mSulleza/esp32/hardware/kicad/finished_3d.png

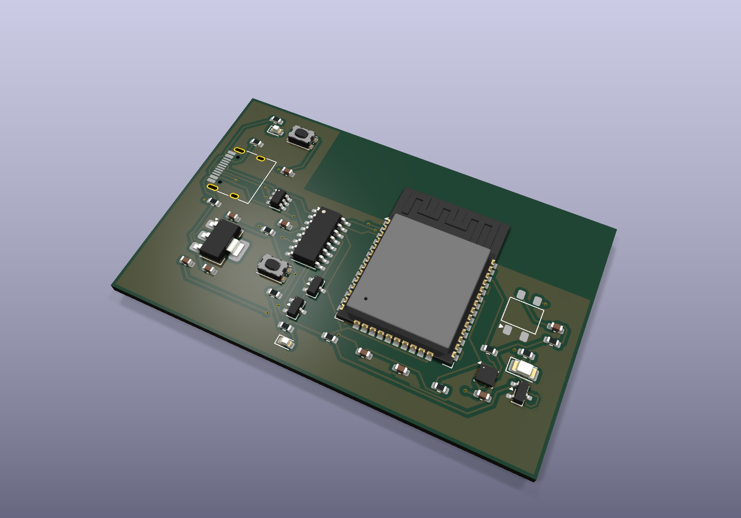
hardware/kicad/finished_3d.png
