mSulleza/esp32/hardware/kicad/placed_top.png

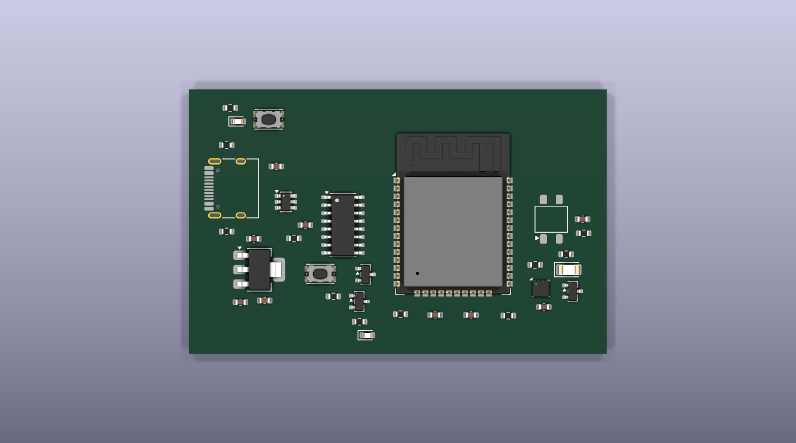
hardware/kicad/placed_top.png
