mSulleza/esp32/hardware/enclosure/enclosure_3d.png

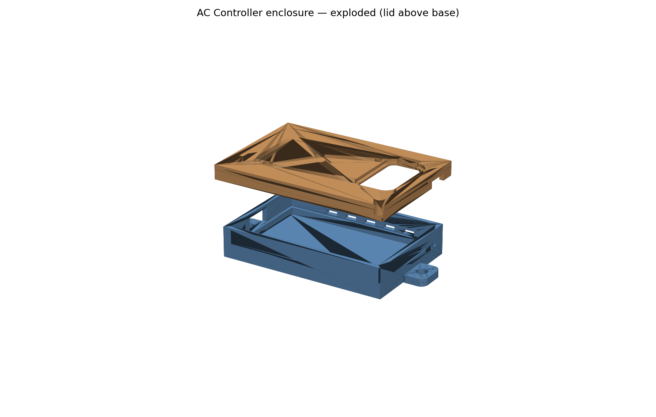
hardware/enclosure/enclosure_3d.png
