mSulleza/esp32/hardware/enclosure/enclosure_plan.png

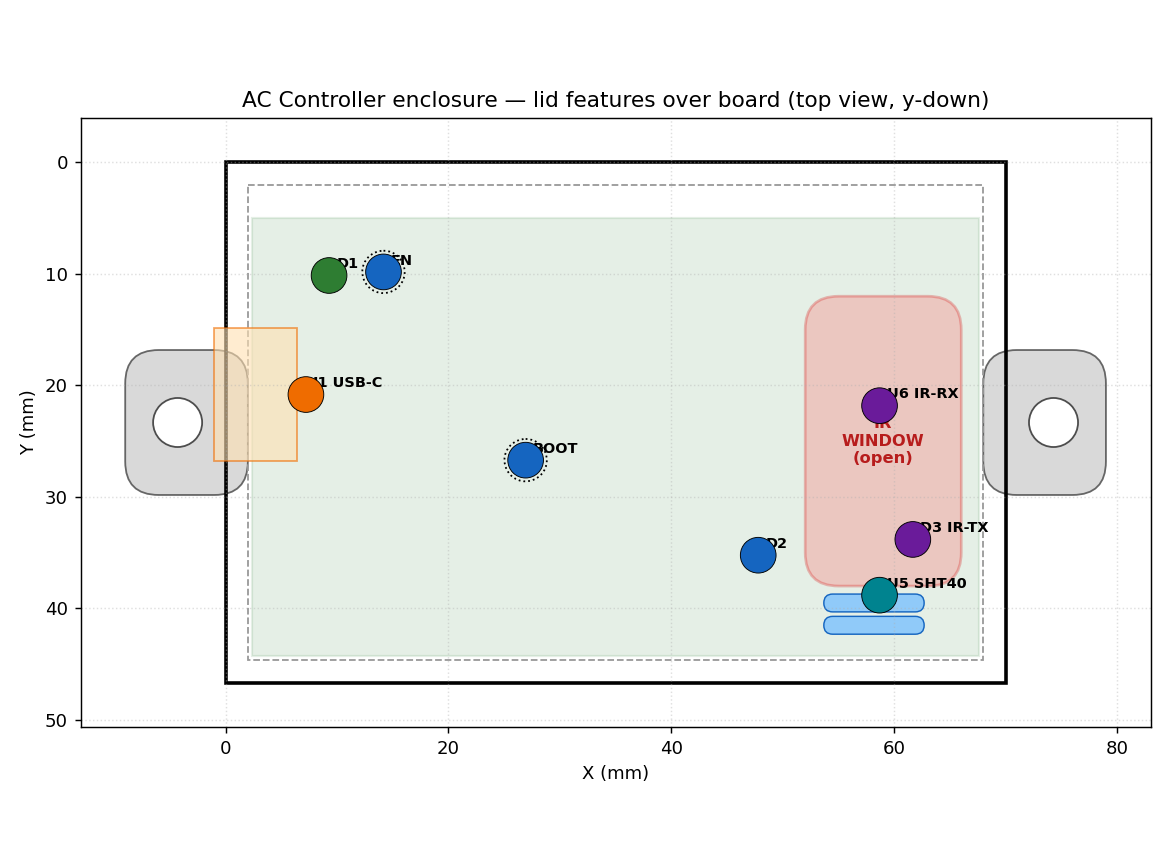
hardware/enclosure/enclosure_plan.png
