mSulleza/esp32/hardware/fab-sht40/ac_controller_top.png

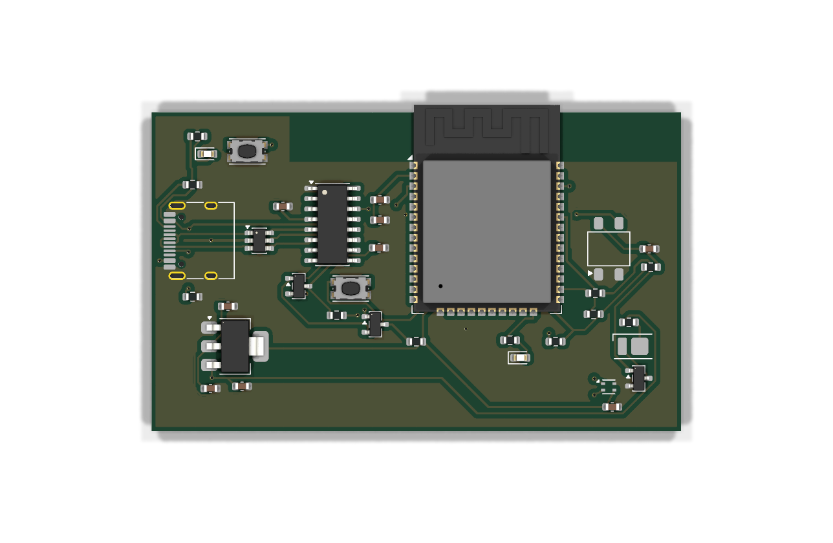
hardware/fab-sht40/ac_controller_top.png
