mSulleza/esp32/hardware/kicad/board3d.png

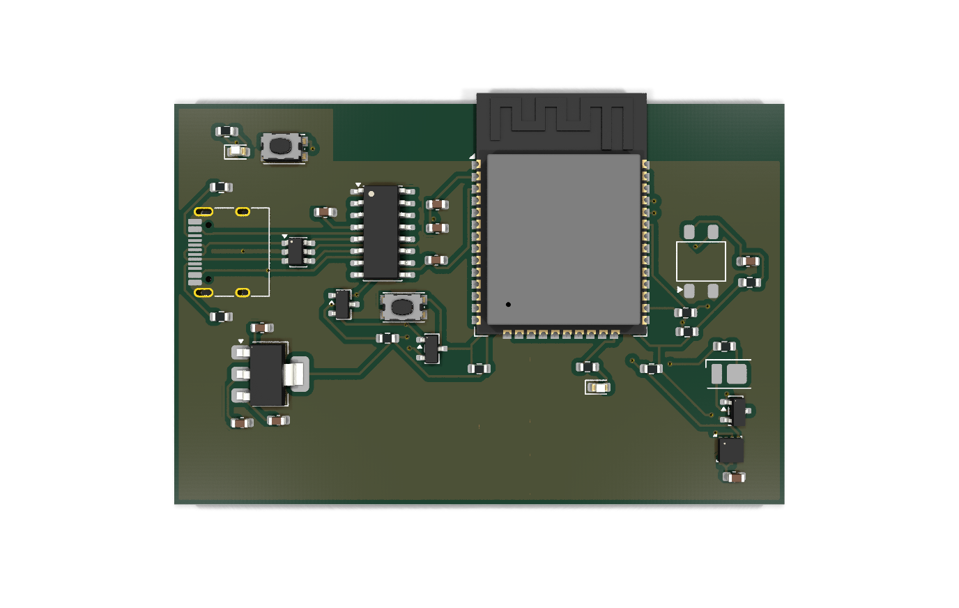
hardware/kicad/board3d.png
