mSulleza/esp32/hardware/enclosure/lid.stl

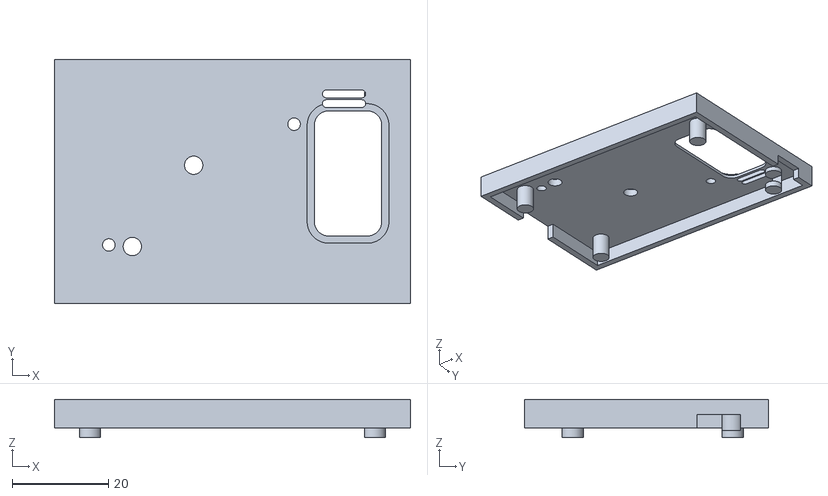
[picture p7: CAD file, 2026-07-01]
hardware/enclosure/lid.stl
74.0 x 50.7 x 8.00
