mSulleza/esp32/hardware/enclosure/ac_controller_enclosure.3mf

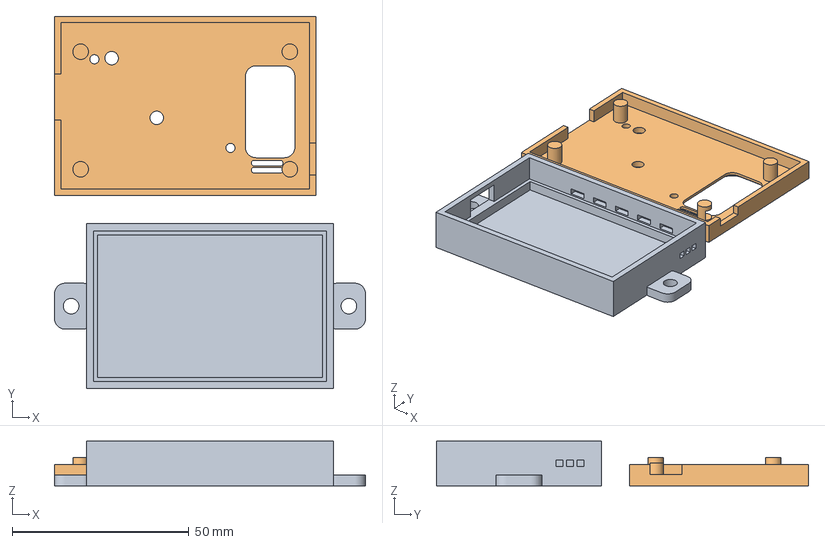
[picture p8: CAD file, 2026-07-01]
hardware/enclosure/ac_controller_enclosure.3mf
88.0 x 105.3 x 12.6 mm
base
lid_print_top_down
