mSulleza/esp32/hardware/enclosure/base.stl

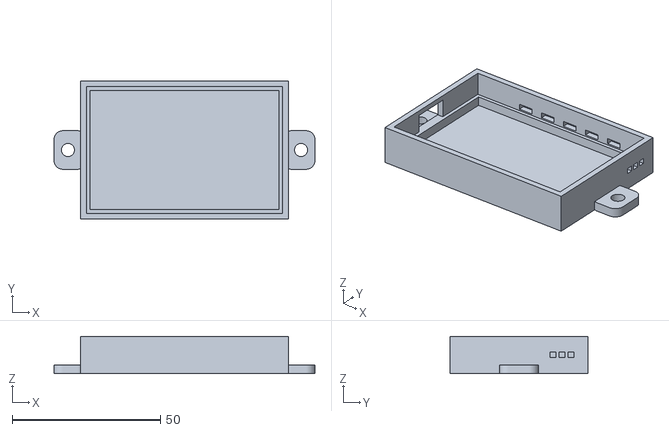
[picture p9: CAD file, 2026-07-01]
hardware/enclosure/base.stl
88.0 x 46.7 x 12.6
