mSulleza/esp32/hardware/kicad/ac_controller.pdf

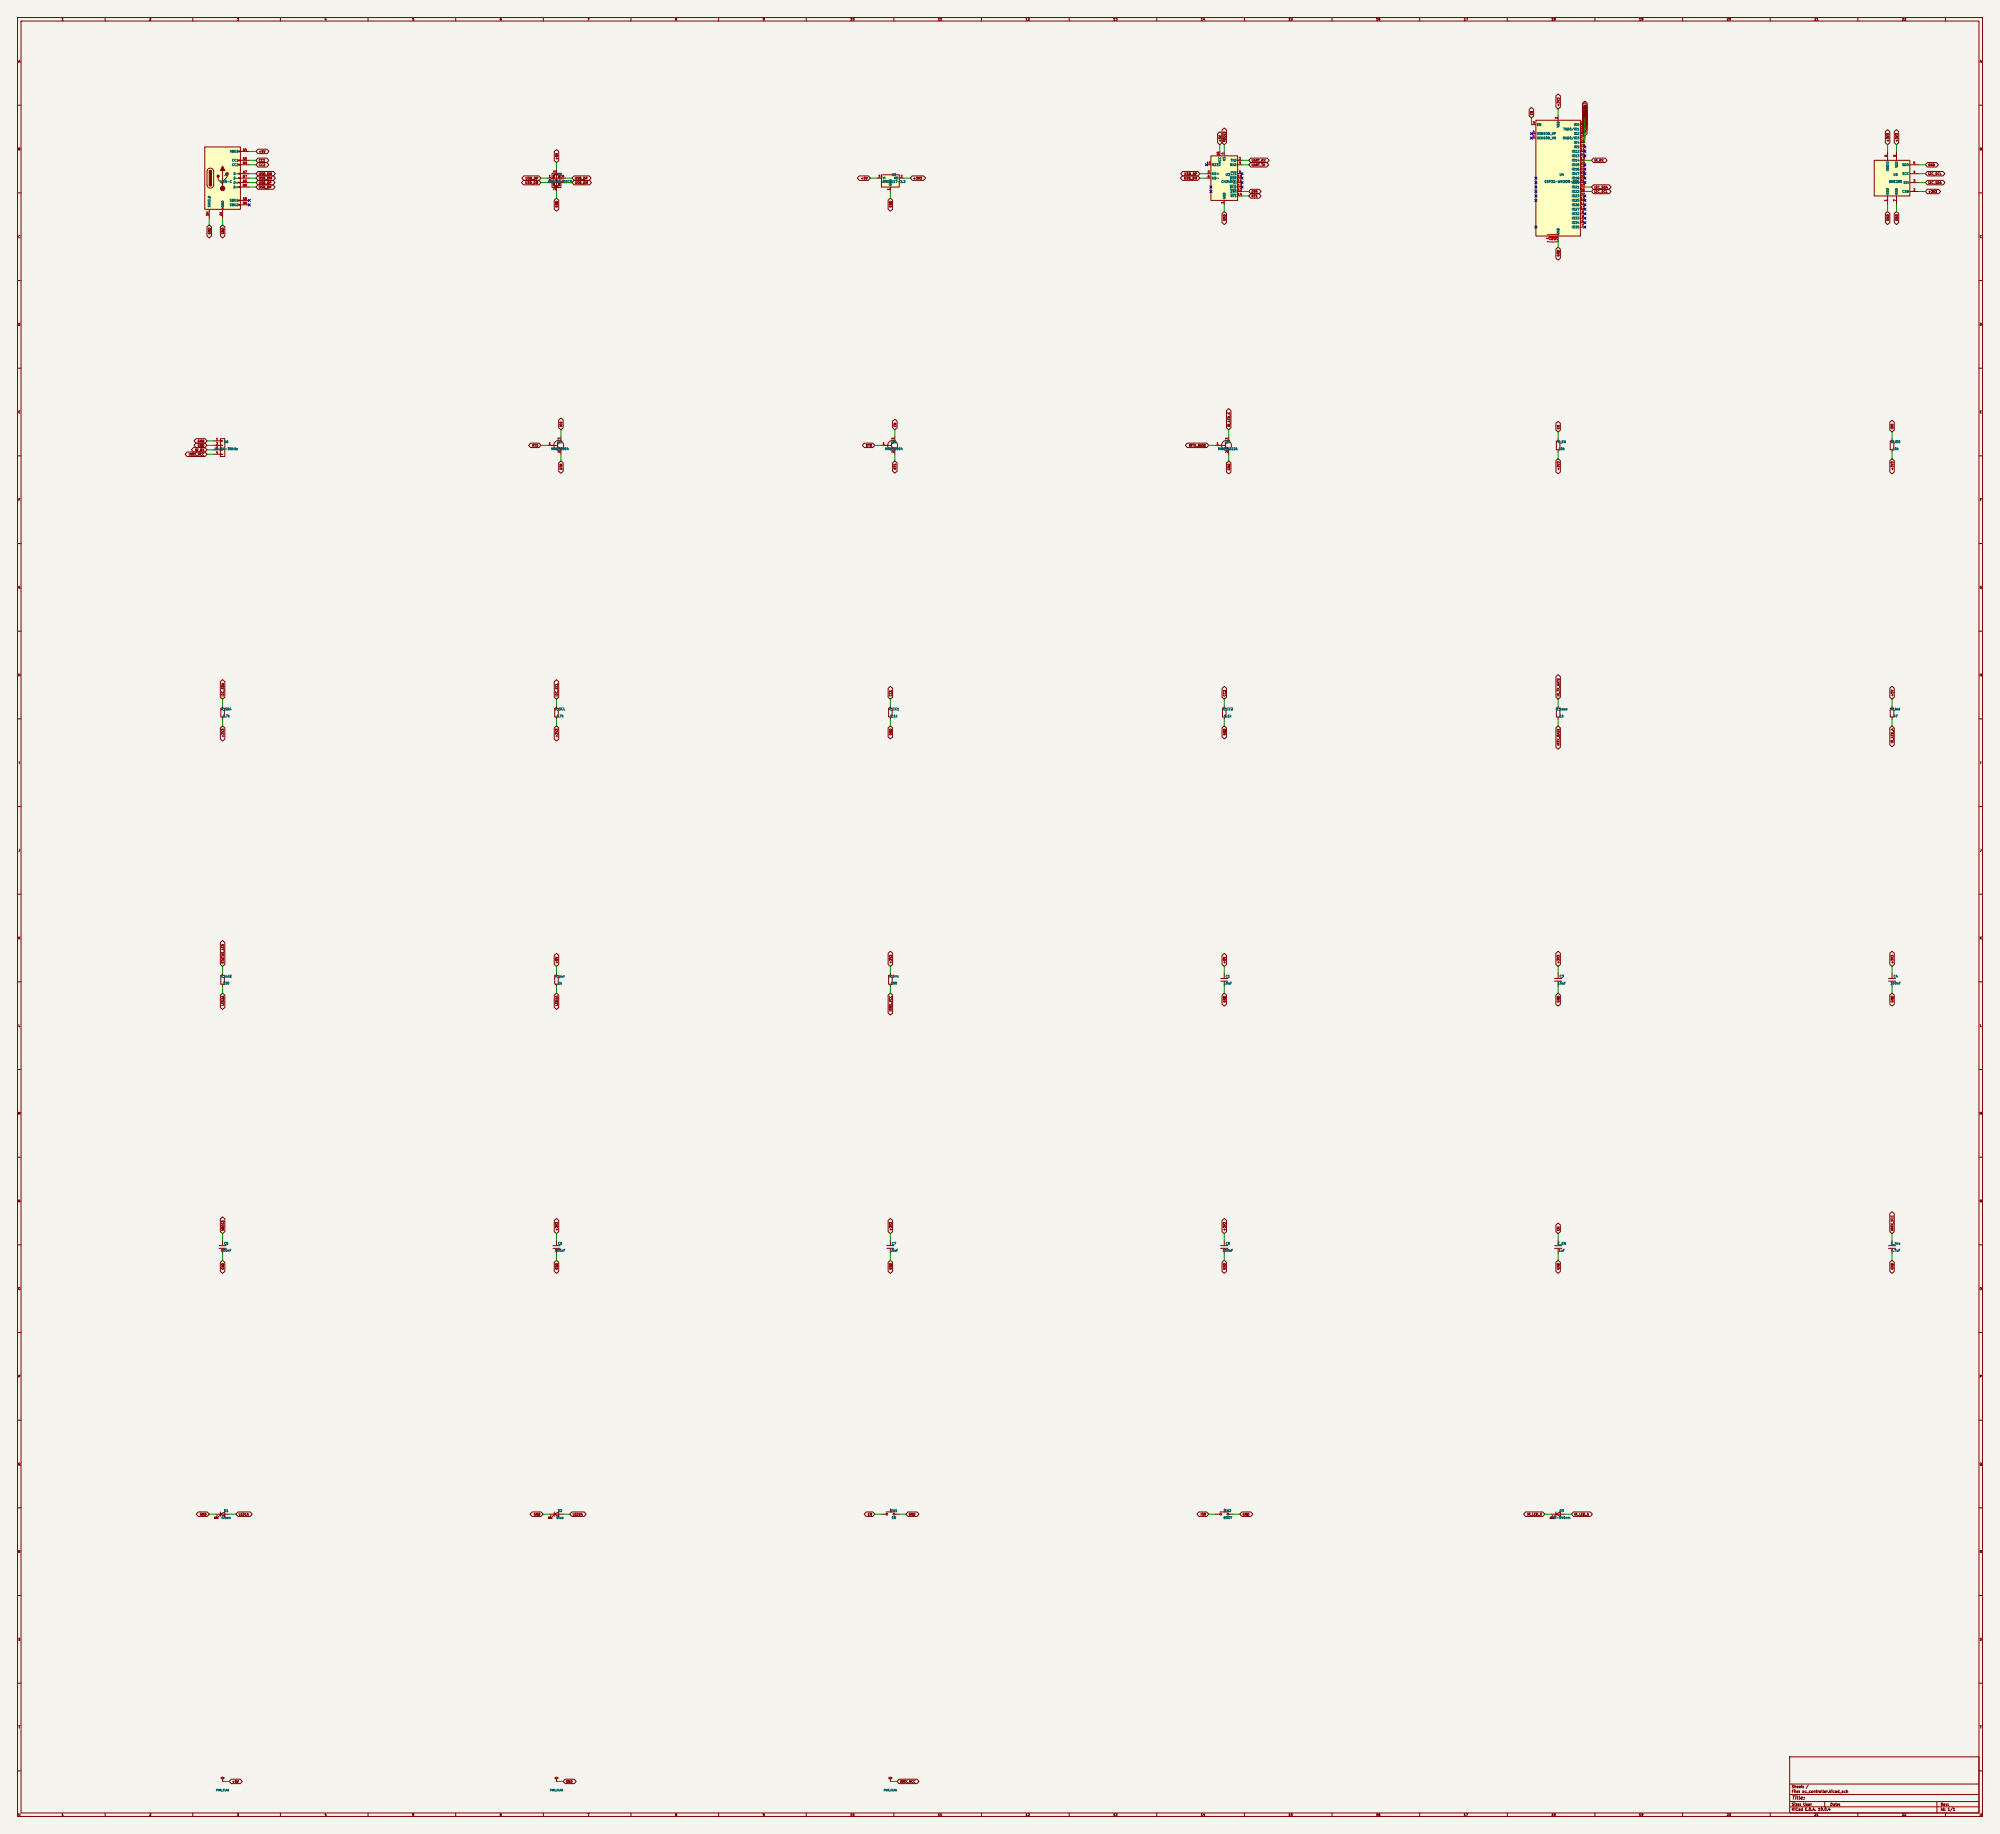
[picture p10: page 1]

Size: User | Rev:
KiCad E.D.A. 10.0.4 | Id: 1/1
