mSulleza/esp32/hardware/kicad/ac_controller.kicad_pcb

## KiCad design hardware/kicad/ac_controller.kicad_pcb (2026-07-01)

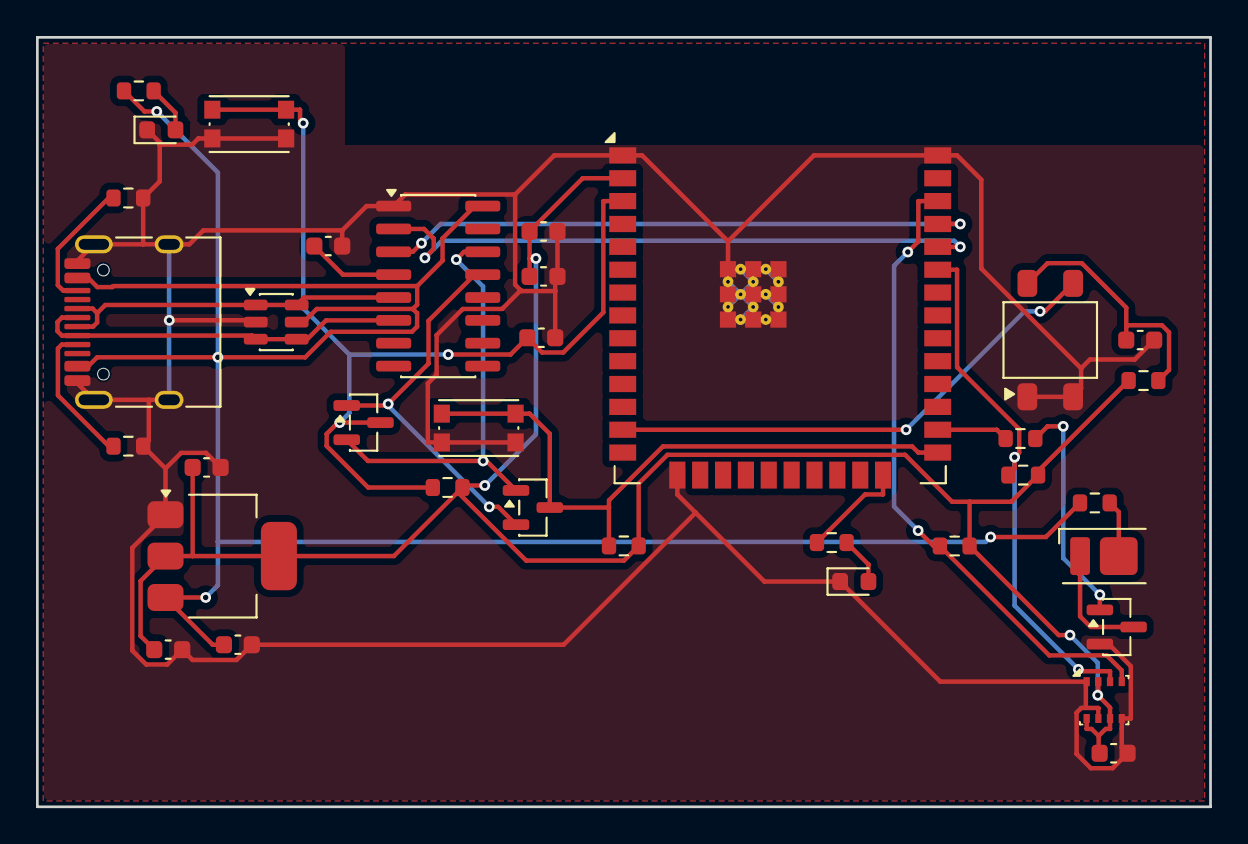
[picture p11: board ac_controller.kicad_pcb from above]

Board: 2 copper layers, 65.2 x 42.7 mm, 35 parts (0 on the bottom side), 25 nets.

Parts:
C1, C3, C4, C5, C6, C7, C8: C_0603_1608Metric
C_EN: C_0603_1608Metric
C_irrx: C_0603_1608Metric
D1, D2: LED_0603_1608Metric
D3: LED_Everlight-SMD3528_3.5x2.8mm_67-21ST
J1: USB_C_Receptacle_HRO_TYPE-C-31-M-12
Q1, Q2, Q3: SOT-23
R_CC1, R_CC2: R_0603_1608Metric
R_EN: R_0603_1608Metric
R_IO0: R_0603_1608Metric
R_SCL: R_0603_1608Metric
R_SDA: R_0603_1608Metric
R_base: R_0603_1608Metric
R_irrx: R_0603_1608Metric
R_led, R_led2: R_0603_1608Metric
R_pwr: R_0603_1608Metric
SW1, SW2: SW_Push_1P1T_NO_CK_KMR2
U1: SOT-23-6
U2: SOT-223-3_TabPin2
U3: SOIC-16_3.9x9.9mm_P1.27mm
U4: ESP32-WROOM-32E
U5: Bosch_LGA-8_2.5x2.5mm_P0.65mm_ClockwisePinNumberi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; Bosch_LGA-8_2.5x2.5mm_P0.65mm_ClockwisePinNumbering
U6: Everlight_IRM-H6xxT

Connections:
+3V3: C3.1, C4.1, C6.1, C7.1, C8.1, R_EN.2, R_IO0.2, R_SCL.2, R_SDA.2, R_irrx.1, U2.2, U4.2, U5.2, U5.6, U5.8
+5V: C1.1, J1.A4, J1.A9, J1.B4, J1.B9, R_led.1, R_pwr.1, U1.5, U2.3, U3.16
CC1: J1.A5, R_CC1.1
CC2: J1.B5, R_CC2.1
DTR: Q1.2, Q2.1, U3.13
EN: C_EN.1, Q2.3, R_EN.1, SW1.1, U4.3
GND: C1.2, C3.2, C4.2, C5.2, C6.2, C7.2, C8.2, C_EN.2, C_irrx.2, D1.1, D2.1, J1.A1, J1.A12, J1.B1, J1.B12, J1.SH, Q3.2, R_CC1.2, R_CC2.2, SW1.2, SW2.2, U1.2, U2.1, U3.1, U4.1, U4.15, U4.38, U4.39, U5.1, U5.5, U5.7, U6.1, U6.2
I2C_SCL: R_SCL.1, U4.36, U5.4
I2C_SDA: R_SDA.1, U4.33, U5.3
IO0: Q1.3, R_IO0.1, SW2.1, U4.25
IRRX_VCC: C_irrx.1, R_irrx.2, U6.4
IRTX_BASE: Q3.1, R_base.2
IR_LED_A: D3.2, R_led.2
IR_LED_K: D3.1, Q3.3
IR_RX: U4.13, U6.3
IR_TX_GATE: R_base.1, U4.26
LED1A: D1.2, R_pwr.2
LED2A: D2.2, R_led2.2
RTS: Q1.1, Q2.2, U3.14
STATUS_LED: R_led2.1, U4.24
UART_RX: U3.2, U4.34
UART_TX: U3.3, U4.35
USB_DM: J1.A7, J1.B7, U1.3, U1.4, U3.6
USB_DP: J1.A6, J1.B6, U1.1, U1.6, U3.5
VREG3: C5.1, U3.4
