mSulleza/esp32/(commit log)

2026-07-01 Initial commit: ESP32 smart AC controller
    IR-based smart AC controller with an ESP32 that learns/replays remote
    codes, reads temperature & humidity, and runs schedules locally. Includes
    firmware, AWS IoT (CDK) backend, KiCad hardware design, enclosure, and docs.
    [BOM.csv, ac_controller.kicad_pcb, ac_controller.kicad_sch, ac_controller_bom.csv, ac_controller_enclosure.3mf, base.stl, finished.kicad_pcb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]
2026-11-07 fix(security): owner-only device access, validated API input, verified OTA TLS
    Backend
    - api: a device is served only to its recorded owner; rows with no ownerSub
    are served to nobody. Bad JSON returns 400 inside the try; 500s no longer
    echo the error to clients (logged with a requestId instead).
    - api: command, capture and schedule bodies are validated: allowed keys only,
    mode/fan/swing enums, integer tempC 16-30, labels [A-Za-z0-9_-]{1,32},
    daysOfWeek 1-7 distinct ints 0-6, time HH:MM, at most 32 schedules and a
    sync message that fits the device's 2048-byte MQTT buffer. PUT without a
    schedules array no longer wipes the list.
    - ingest: every device update has ConditionExpression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
    [cloud.cpp, config.h, ota.cpp, ota.h]
